myen7216/Pandas-mp3/assets/media/README.md

# Build photos and videos

Photos and recordings of Panda's ESP32 MP3 player, from the breadboard prototype to the soldered assembly.

[Back to the project README](../../README.md)

## Photos

### Finished assembly — front and controls

Finished assembly — front and controls

### Side view — internal wiring and stacked boards

Side view — internal wiring and stacked boards

### Rear view — soldered connections

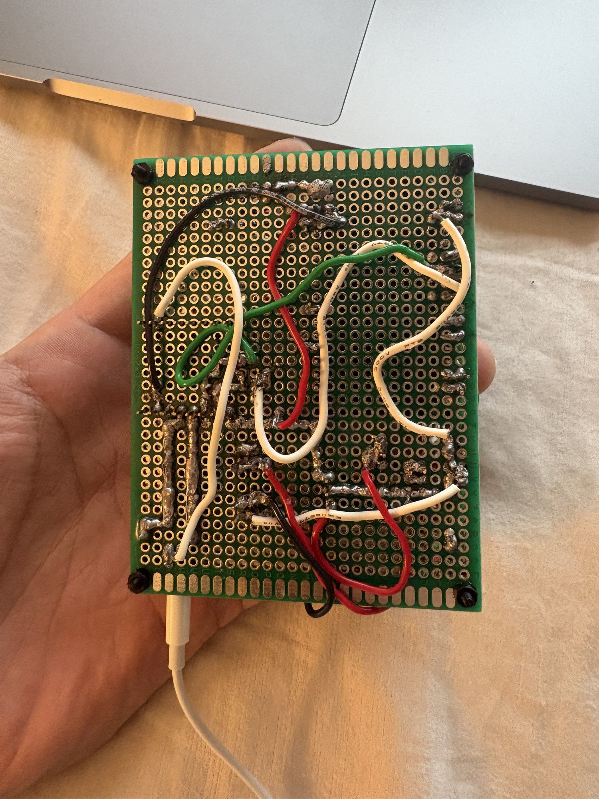
[picture p6: assets/media/IMG_7911.jpg]
Rear view — soldered connections


### Side view — battery and board spacing

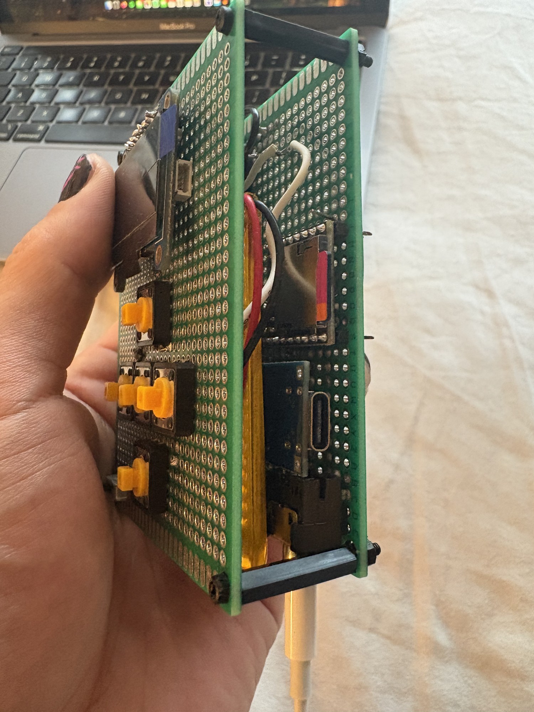
[picture p7: assets/media/IMG_7912.jpg]
Side view — battery and board spacing


### Internal layout from the opposite side

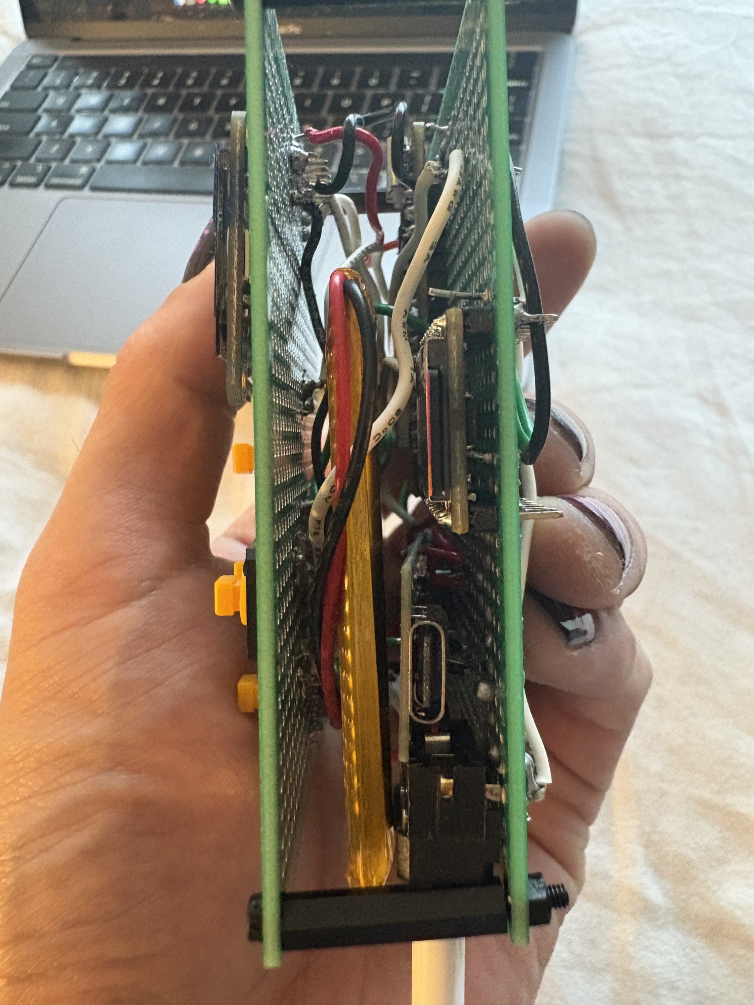
[picture p8: assets/media/IMG_7913.jpg]
Internal layout from the opposite side


### Breadboard prototype with battery and OLED

Breadboard prototype with battery and OLED

### Hand-drawn wiring sketch

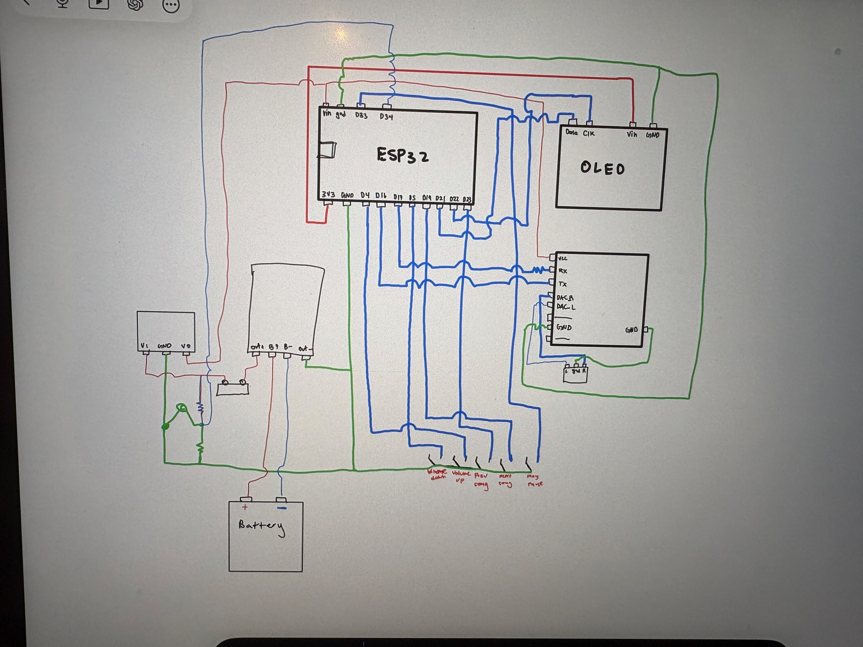
[picture p9: assets/media/IMG_7032.jpg]
Hand-drawn wiring sketch


The hand-drawn sketch records the build process. For the final pin assignments, power connections and jack contacts, use the [wiring guide](../../docs/WIRING.md).

## Video demos

Click a thumbnail or its MP4 link to open/download the full clip. The copies include the original stereo recording; no clip was intentionally trimmed.

### Soldered player demonstration

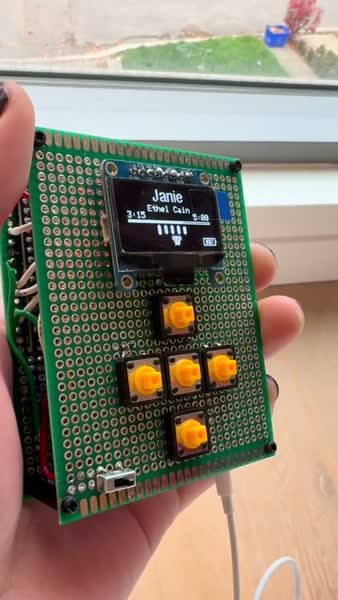
[picture p10: assets/media/IMG_7914-poster.jpg]
Soldered player demonstration


[Open/download IMG_7914.mp4](IMG_7914.mp4) · 0:26 · 10.58 MiB

### Breadboard build and power-stage recording

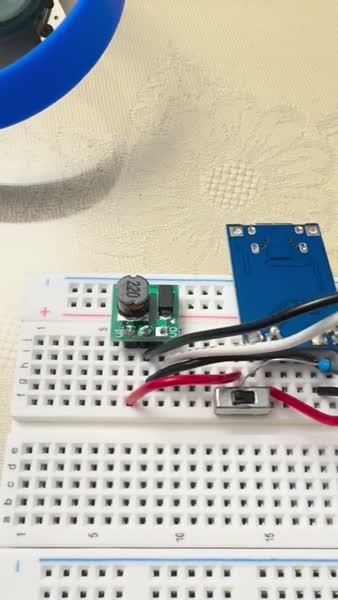
[picture p11: assets/media/IMG_6539-poster.jpg]
Breadboard build and power-stage recording


[Open/download IMG_6539.mp4](IMG_6539.mp4) · 0:30 · 8.05 MiB

### Breadboard player demonstration

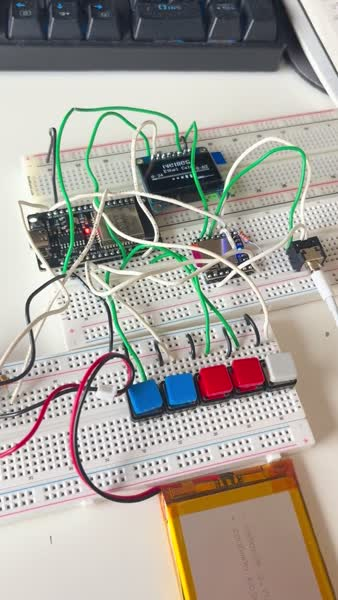
[picture p12: assets/media/IMG_6520-poster.jpg]
Breadboard player demonstration


[Open/download IMG_6520.mp4](IMG_6520.mp4) · 1:08 · 13.39 MiB

### Early prototype recording — clip 2

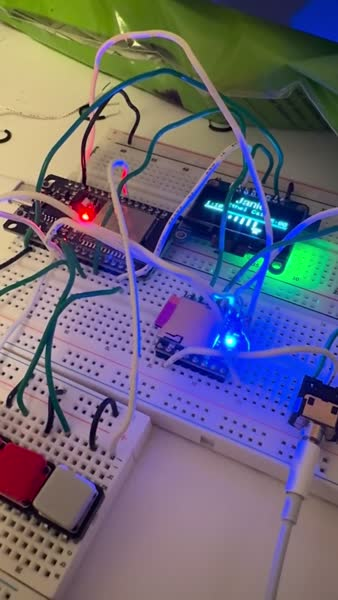
[picture p13: assets/media/IMG_6486-poster.jpg]
Early prototype recording — clip 2


[Open/download IMG_6486.mp4](IMG_6486.mp4) · 0:05 · 0.62 MiB

### Early prototype recording — clip 1

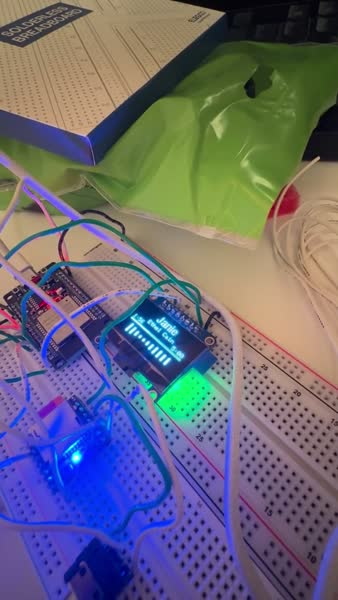
[picture p14: assets/media/IMG_6482-poster.jpg]
Early prototype recording — clip 1


[Open/download IMG_6482.mp4](IMG_6482.mp4) · 0:06 · 0.53 MiB

## File formats

The five HEIC photos were converted to JPEG, and the two supplied JPEGs were resized alongside them (longest edge up to 2000 pixels). The five MOV recordings were converted to full-length H.264/AAC MP4 copies, up to 1280 pixels on the longest edge. HDR recordings were converted to SDR for broader compatibility. Source filenames are preserved in recognizable form; the original Downloads files were not modified.

The repository contains the web copies, not duplicate camera originals. [manifest.json](manifest.json) maps each of the 12 supplied originals to its published copy and records sizes, durations and checksums.
