myen7216/Pandas-mp3/assets/bamboo-game.png

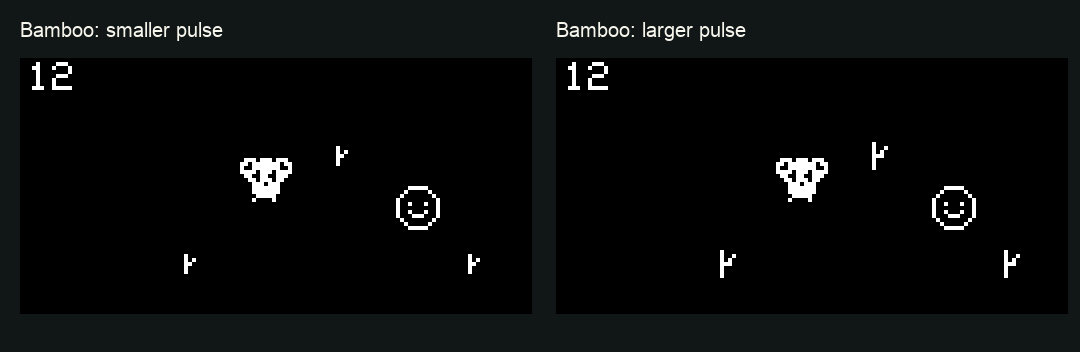
assets/bamboo-game.png
