myen7216/Pandas-mp3/assets/game-over.png

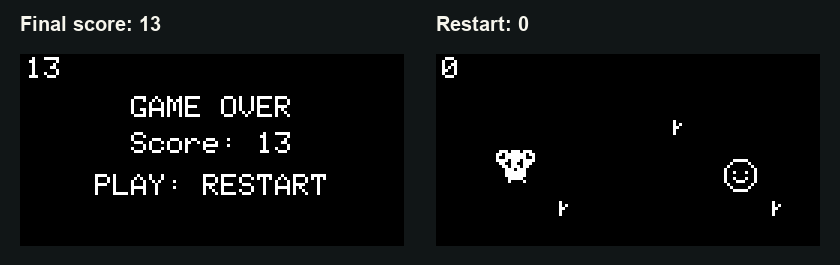
assets/game-over.png
