myen7216/Pandas-mp3/assets/paused.png

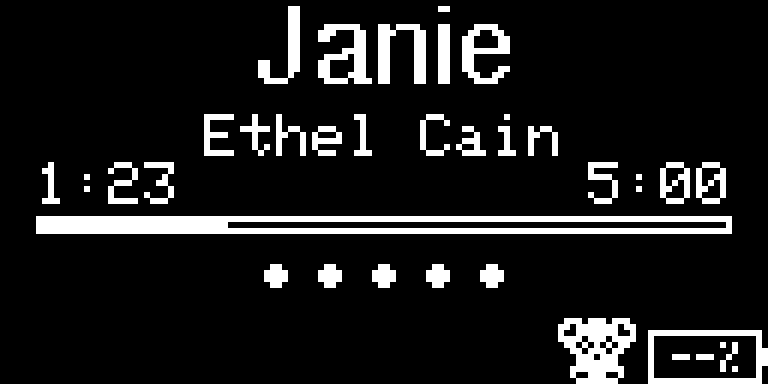
assets/paused.png
