myen7216/Pandas-mp3/assets/volume.png

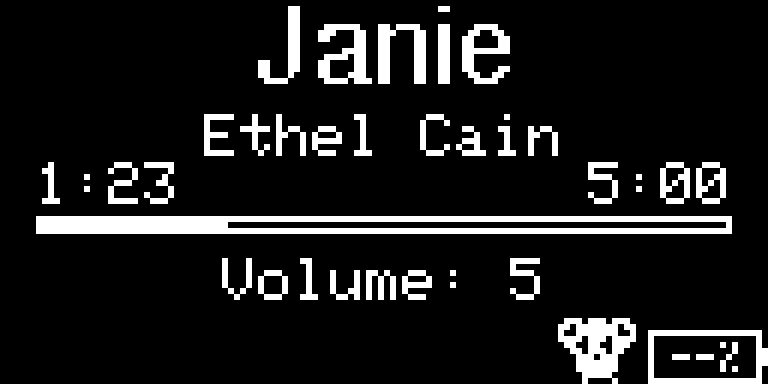
assets/volume.png
